abigaelbousquet/engn1650-bici-pcb/README.md

# engn1650-bici-pcb
Altium project for ENGN1650 Capstone Project: Bici Bike Indicator Helmet Attachment
