abigaelbousquet/engn1650-bici-pcb/bici-pcb-BOM-V5.xlsx

Name | Description | Designator | Quantity | Manufacturer | Manufacturer PN | Vendor | Vendor PN | Value | Package
GMC10X7R475K10NT | CAP0603 X7R 4.7UF 10% 10V | C1, C2, C401 | 3 | Cal-Chip Electronics, Inc. | GMC10X7R475K10NT | DigiKey | 4713-GMC10X7R475K10NTCT-ND | 4.7uF 10V | 0603
GRM188R61A106ME69D | CAP CER 10UF 10V X5R 0603 | C3, C4, C5 | 3 | Murata Electronics | GRM188R61A106ME69D | DigiKey | 490-10475-1-ND | 10 uF 10 V | 0603
KGM15AR70J104JT | CAP CER 0.1UF 6.3V X7R 0603 | C6, C101, C201, C202, C402, C403, C404, C405, C406 | 9 | KYOCERA AVX | KGM15AR70J104JT | DigiKey | 478-KGM15AR70J104JTCT-ND | 0.1uF 6.3V | 0603
GRM188R61E225KA12D | CAP CER 2.2UF 25V X5R 0603 | C102 | 1 | Murata Electronics | GRM188R61E225KA12D | DigiKey | 490-10731-1-ND | 2.2 uF 25 V | 0603
KGM15AV51H103ZT | CAP CER 10000PF 50V Y5V 0603 | C103 | 1 | KYOCERA AVX | KGM15AV51H103ZT | DigiKey | 478-KGM15AV51H103ZTCT-ND | 10 nF 50V | 0603
T1681UY--20C000212U1930 | LED AMBER CLEAR 4PLCC SMD | D1, D201, D202, D203, D204, D205, D206, D207, D208, D209, D210, D211, D212, D213, D214 | 15 | Harvatek Corporation | T1681UY--20C000212U1930 | DigiKey | 3147-T1681UY--20C000212U1930CT-ND |  | 4-PLCC
SDR08C04LP3-7B | DIODE SCHOTTK 4V 80MA X3DFN06032 | D301, D302 | 2 | Diodes Incorporated | SDR08C04LP3-7B | DigiKey | 31-SDR08C04LP3-7BCT-ND |  | 0201
AP3216ID | LED RED DIFFUSED CHIP SMD | D401 | 1 | Kingbright | AP3216ID | DigiKey | 754-AP3216IDCT-ND |  | 1206
USB4125-GF-A | CONN RCPT TYPE C 6P SMD RA | J1 | 1 | GCT | USB4125-GF-A | DigiKey | 2073-USB4125-GF-ACT-ND
0530480210 | CONN HEADER R/A 2POS 1.25MM | J2 | 1 | Molex | 0530480210 | DigiKey | WM1742-ND
3220-14-0100-00 | CONN HEADER VERT 14POS 1.27MM | J401 | 1 | CNC Tech | 3220-14-0100-00 | DigiKey | 1175-1630-ND
CIGW252010GL2R2MNE | FIXED IND 2.2UH 2.2A 93MOHM SMD | L1 | 1 | Samsung Electro-Mechanics | CIGW252010GL2R2MNE | DigiKey | 1276-6933-1-ND | 2.2uH | 1008
SP-1304 | SPEAKR 32OHM 200MW TOP PORT 88DB | LS1, LS2 | 2 | Soberton Inc. | SP-1304 | DigiKey | 433-1095-ND
RC0603FR-075K1L | RES 5.1K OHM 1% 1/10W 0603 | R1, R2 | 2 | YAGEO | RC0603FR-075K1L | DigiKey | 311-5.10KHRCT-ND | 5.1k | 0603
ERJ-3EKF4700V | RES SMD 470 OHM 1% 1/10W 0603 | R3, R401 | 2 | Panasonic Electronic Components | ERJ-3EKF4700V | Mouser | 667-ERJ-3EKF4700V | 470 | 0603
ERJ-3EKF2001V | RES SMD 2K OHM 1% 1/10W 0603 | R4 | 1 | Panasonic Electronic Components | ERJ-3EKF2001V | DigiKey | P2.00KHCT-ND | 2k | 0603
RT0603BRD0750KL | RES 50K OHM 0.1% 1/10W 0603 | R5, R6 | 2 | YAGEO | RT0603BRD0750KL | DigiKey | 13-RT0603BRD0750KLCT-ND | 50k | 0603
ERJ-3GEY0R00V | RES SMD 0 OHM JUMPER 1/10W 0603 | R10, R11 | 2 | Panasonic Electronic Components | ERJ-3GEY0R00V | DigiKey | P0.0GCT-ND | 0 | 0603
ERJ-3EKF1002V | RES SMD 10K OHM 1% 1/10W 0603 | R101, R102, R103, R104, R215, R216, R301, R303, R402, R404 | 10 | Panasonic Electronic Components | ERJ-3EKF1002V | Mouser | 667-ERJ-3EKF1002V | 10k | 0603
ERJ-3EKF1200V | RES SMD 120 OHM 1% 1/10W 0603 | R201, R202, R203, R204, R205, R206, R207, R208, R209, R210, R211, R212, R213, R214 | 14 | Panasonic Electronic Components | ERJ-3EKF1200V | DigiKey | P120HCT-ND | 120 | 0603
ERJ-P06J110V | RES SMD 11 OHM 5% 1/2W 0805 | R302, R304 | 2 | YAGEO | ERJ-P06J110V | DigiKey | P11ADCT-ND | 11 | 0805
SLW-864574-5A-RA-N-D | 8.6 X 4.5 X 6.2 MM, 5 MM RAISED | SW1 | 1 | Same Sky (Formerly CUI Devices) | SLW-864574-5A-RA-N-D | DigiKey | 2223-SLW-864574-5A-RA-N-D-ND
MCP73831T-2ATI/OT | IC BATT CNTL LI-ION 1CEL SOT23-5 | U1 | 1 | Microchip Technology | MCP73831T-2ATI/OT | DigiKey | MCP73831T-2ATI/OTCT-ND |  | SOT-23-5
RT6150B-33GQW | IC REG BCK BST 3.3V 800MA 10WDFN | U2 | 1 | Richtek USA Inc. | RT6150B-33GQW | DigiKey | RT6150B-33GQWCT-ND |  | 10-WDFN
ICM-42670-P | IMU ACCEL/GYRO/TEMP I2C/SPI | U101 | 1 | TDK InvenSense | ICM-42670-P | Mouser | 410-ICM-42670-P |  | LGA-14
MC74HC244ADTR2G | IC BUFFER NON-INVERT 6V 20-TSSOP | U201, U202 | 2 | onsemi | MC74HC244ADTR2G | DigiKey | MC74HC244ADTR2GOSCT-ND |  | 20-TSSOP
DMG1012UW-7 | MOSFET N-CH 20V 1A SOT323 | U301, U302 | 2 | Diodes Incorporated | DMG1012UW-7 | DigiKey | DMG1012UW-7DICT-ND |  | SOT-323
STM32L412C8T6 | IC MCU 32BIT 64KB FLASH 48LQFP | U401 | 1 | STMicroelectronics | STM32L412C8T6 | DigiKey | 497-STM32L412C8T6-ND |  | 48-LQFP
