abigaelbousquet/engn1650-bici-pcb/bici-pcb-V4.pdf

USB-C | Li Ion Battery

## Power Charger

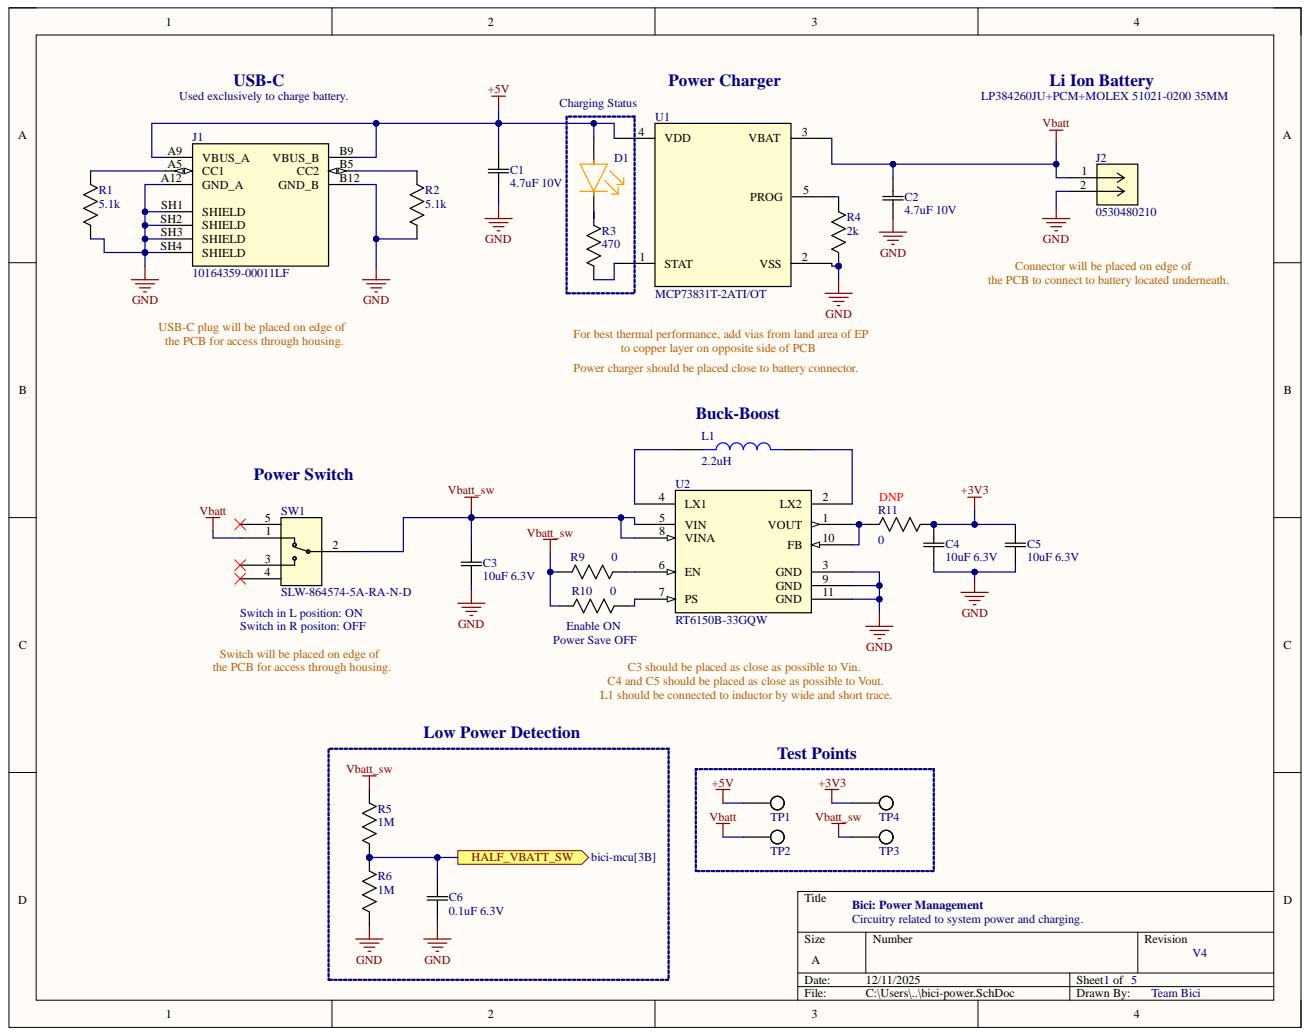
[picture p13: page 1]

Charging Status Used exclusively to charge battery.

Connector will be placed on edge of
the PCB to connect to battery located underneath.

USB-C plug will be placed on edge of
the PCB for access through housing.

For best thermal performance, add vias from land area of EP

to copper layer on opposite side of PCB

Power charger should be placed close to battery connector.

Switch in L position: ON
Switch in R positon: OFF

Switch will be placed on edge of

C3 should be placed as close as possible to Vin.
C4 and C5 should be placed as close as possible to Vout.
L1 should be connected to inductor by wide and short trace.

Bici: Power Management
Circuitry related to system power and charging.

## Test Points

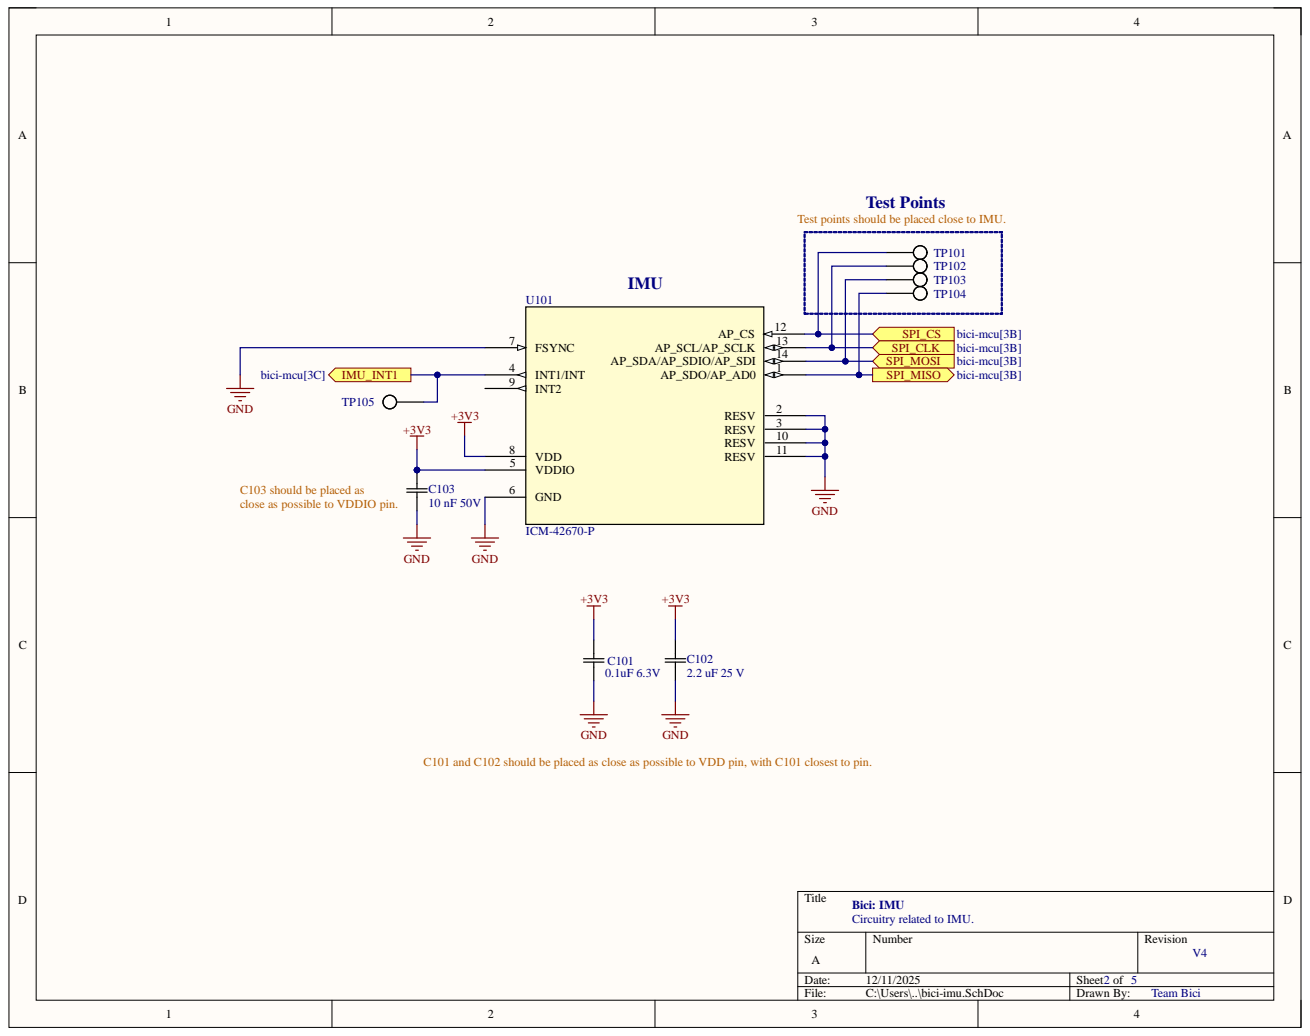
[picture p14: page 2]

Test points should be placed close to IMU.

C103 should be placed as
close as possible to VDDIO pin.

C101 and C102 should be placed as close as possible to VDD pin, with C101 closest to pin.

Bici: IMU
Circuitry related to IMU.

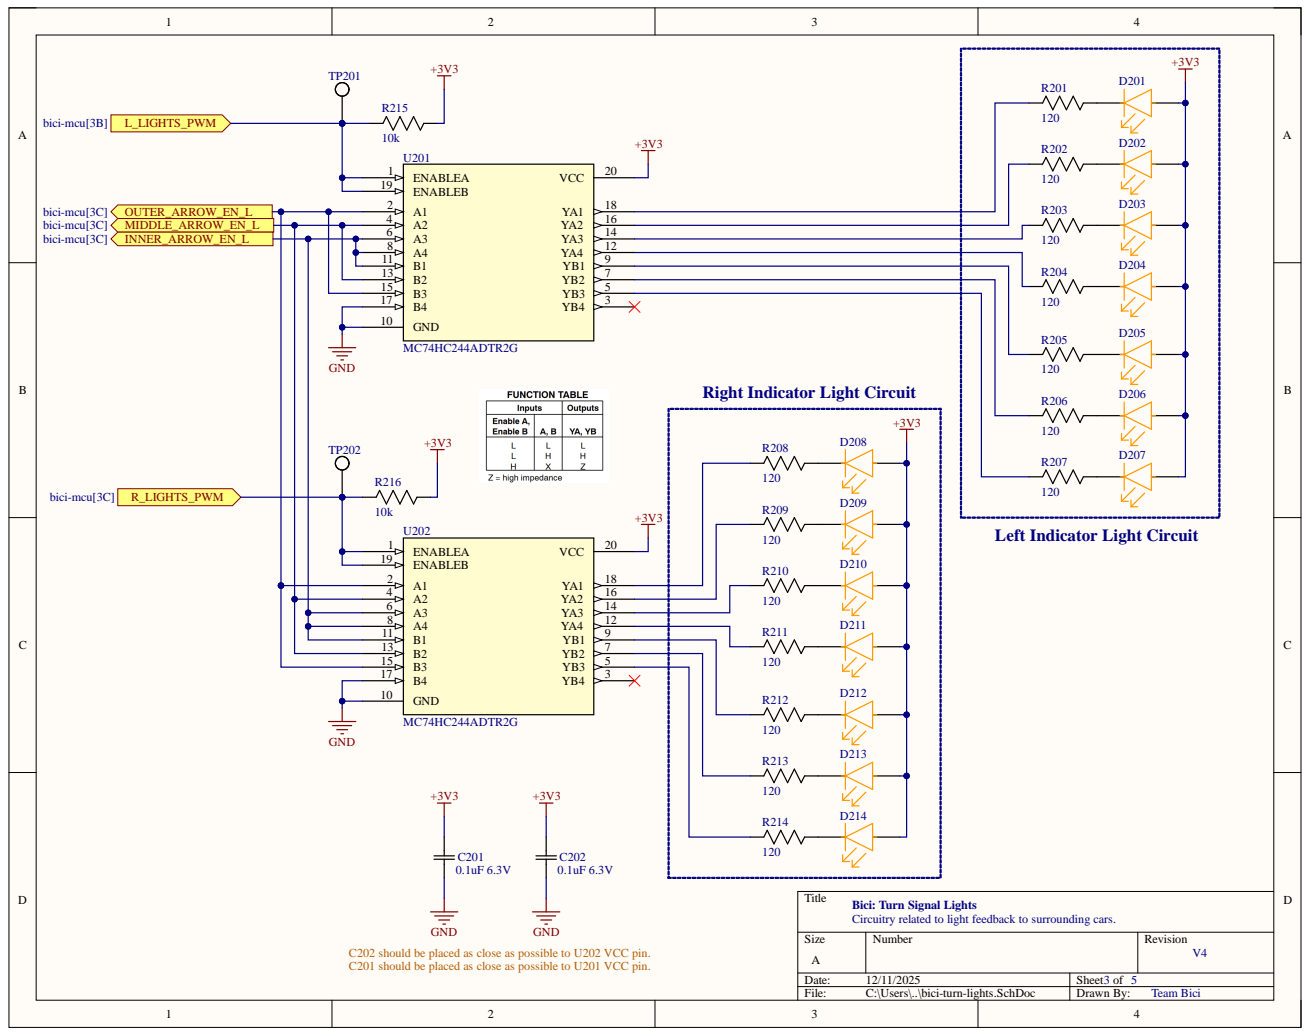
[picture p15: page 3]

Right Indicator Light Circuit

Left Indicator Light Circuit

Bici: Turn Signal Lights
Circuitry related to light feedback to surrounding cars.

C202 should be placed as close as possible to U202 VCC pin.
C201 should be placed as close as possible to U201 VCC pin.

## Left Indicator Audio Feedback Circuit

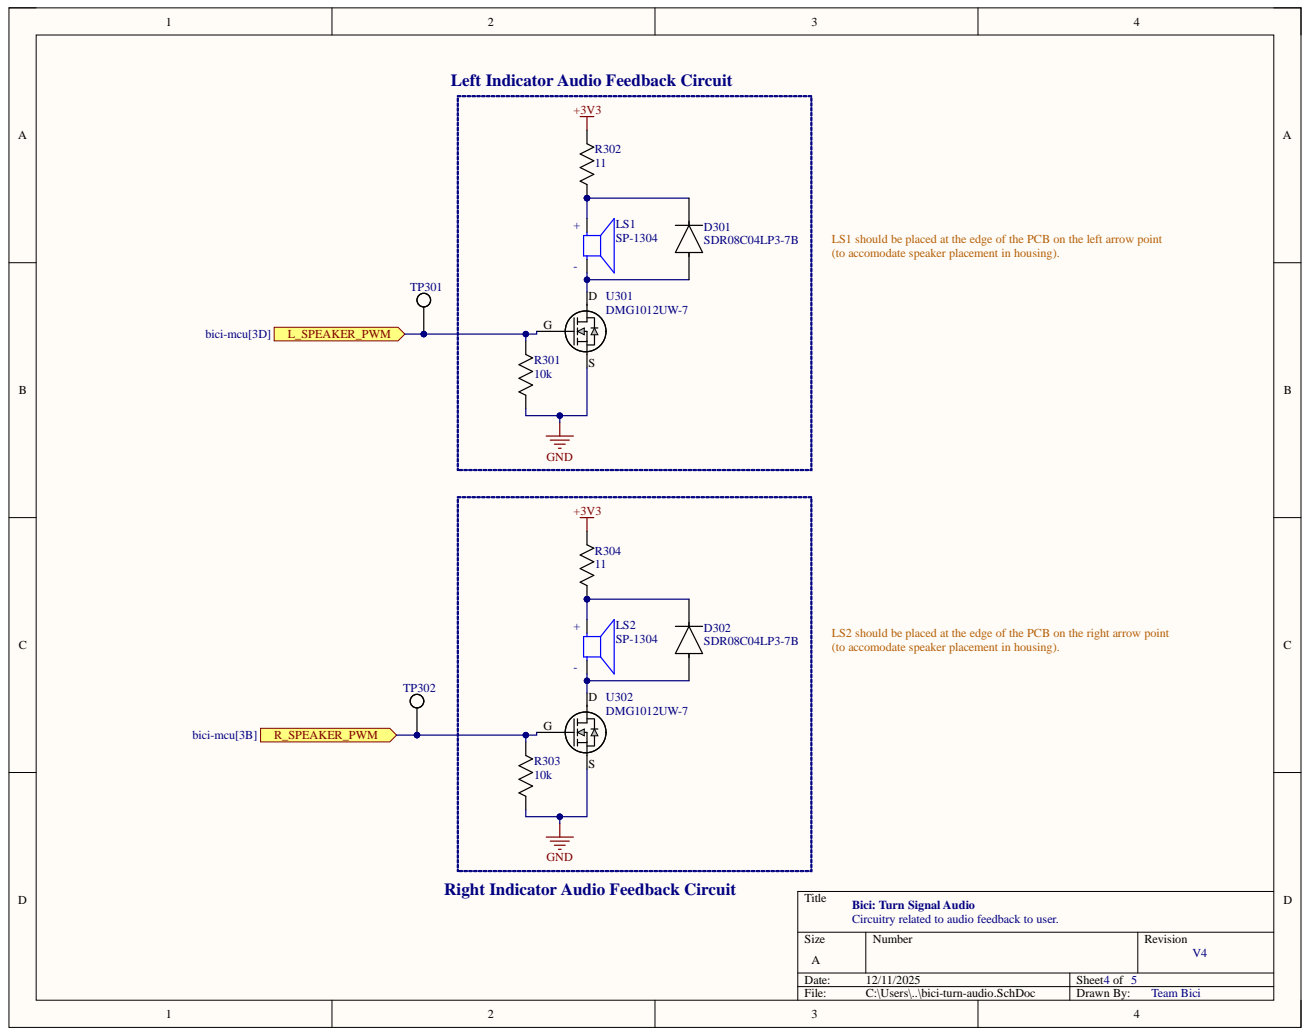
[picture p16: page 4]

LS1 should be placed at the edge of the PCB on the left arrow point
(to accomodate speaker placement in housing).

LS2 should be placed at the edge of the PCB on the right arrow point

Right Indicator Audio Feedback Circuit

Bici: Turn Signal Audio
Circuitry related to audio feedback to user.

STM Power | STM I/O

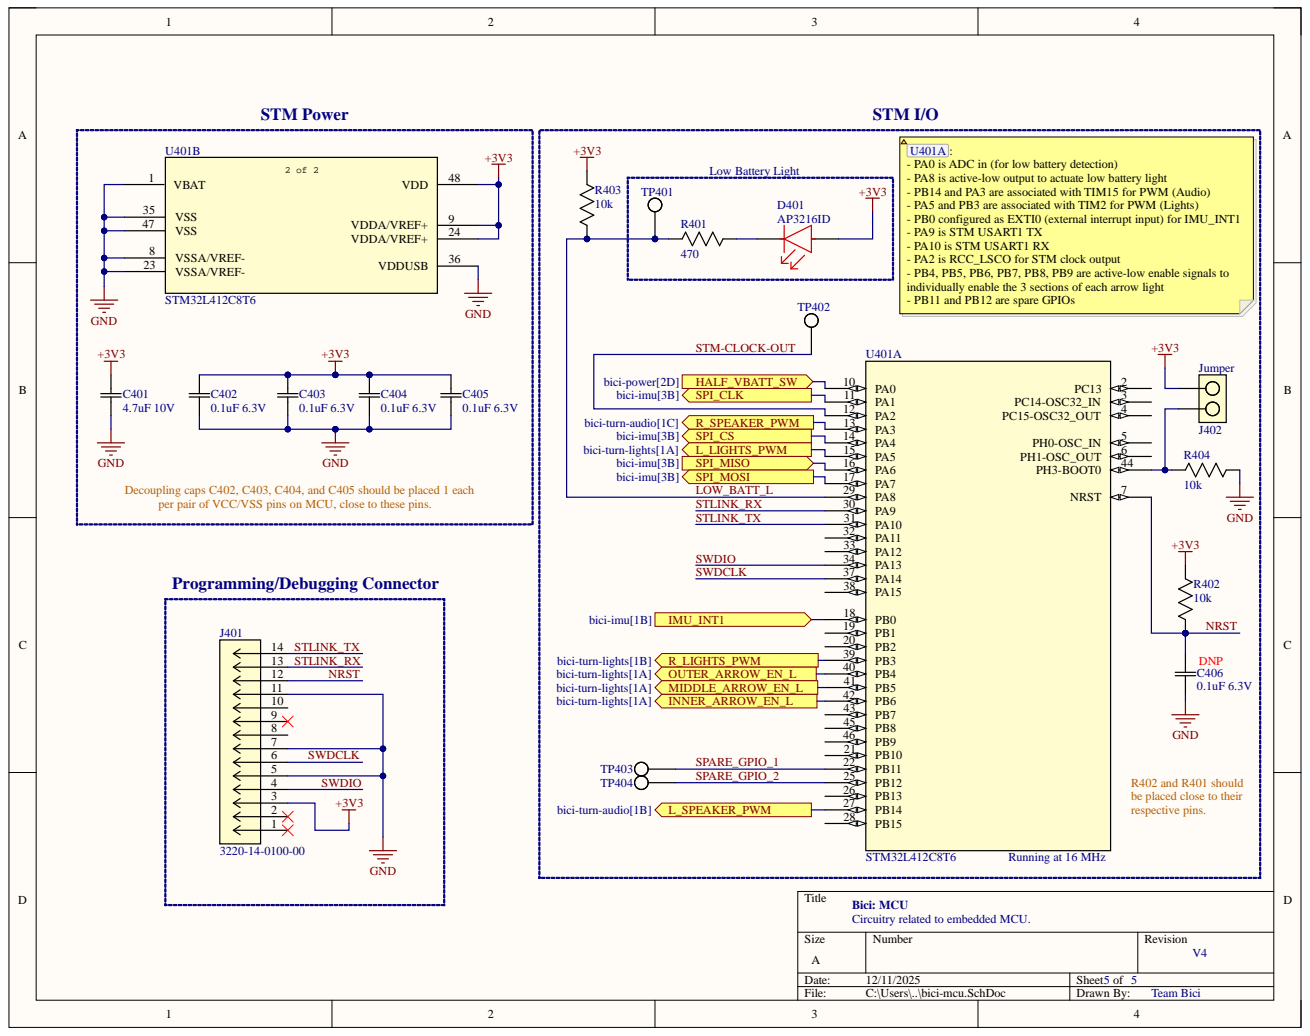
[picture p17: page 5]
