abigaelbousquet/engn1650-bici-pcb/bici-pcb-V2.pdf

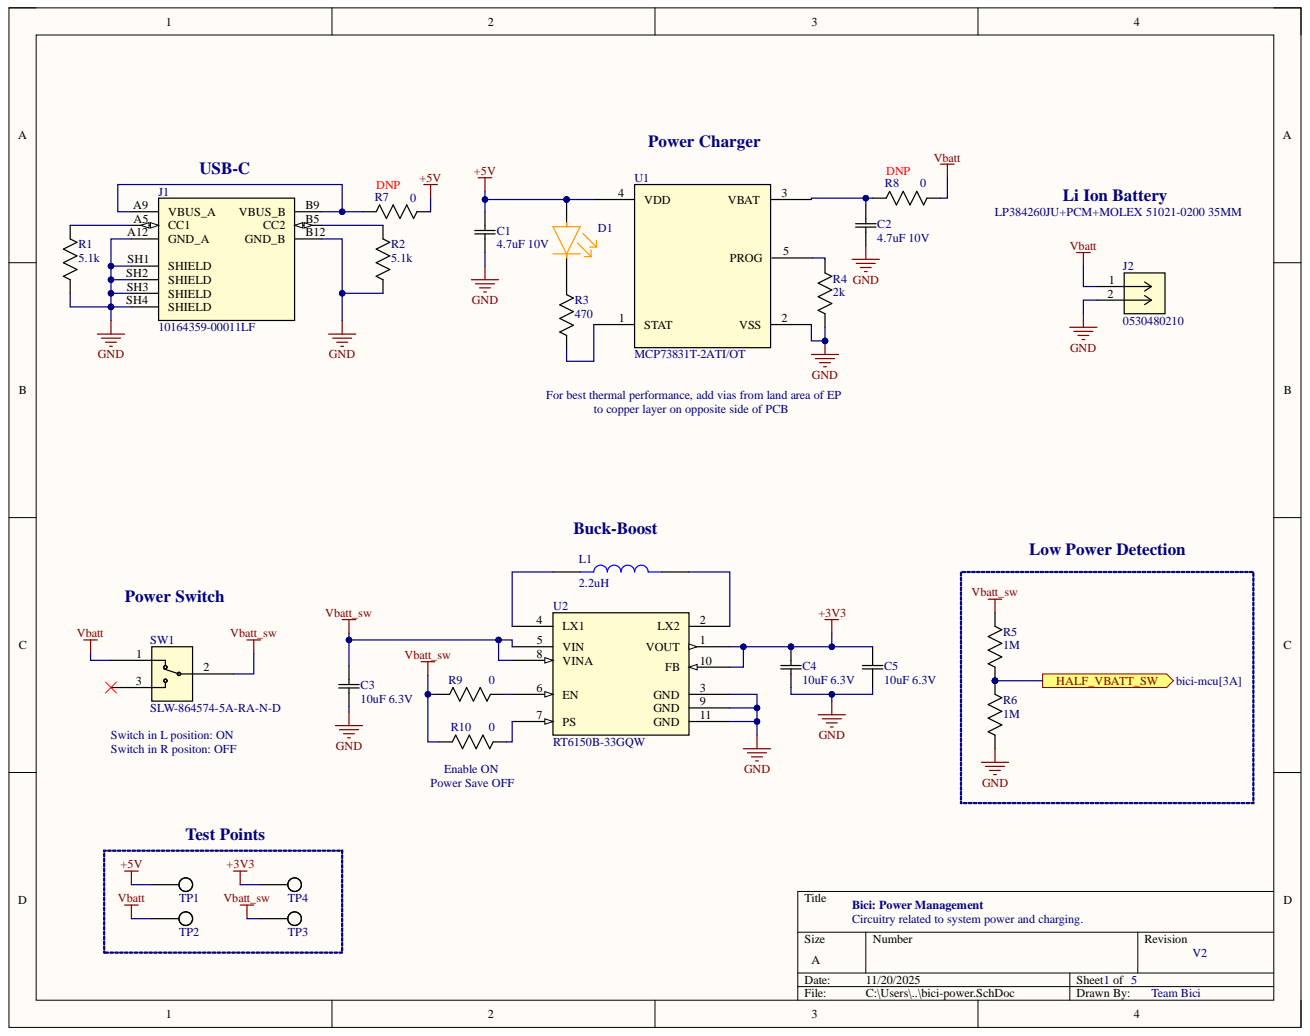
[picture p23: page 1]

For best thermal performance, add vias from land area of EP

to copper layer on opposite side of PCB

Switch in L position: ON
Switch in R positon: OFF

Bici: Power Management
Circuitry related to system power and charging.

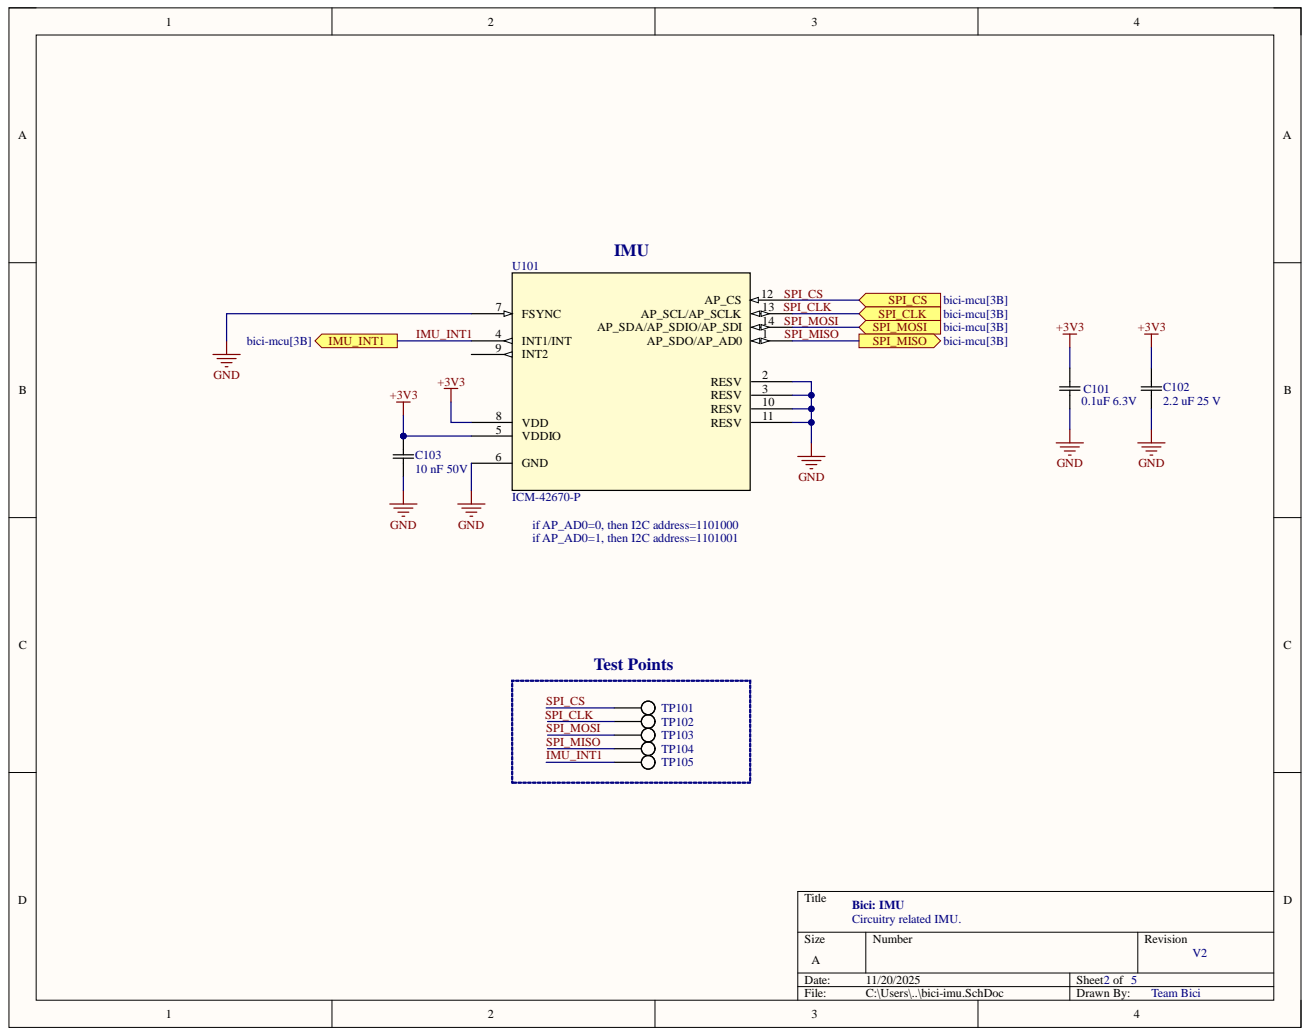
[picture p24: page 2]

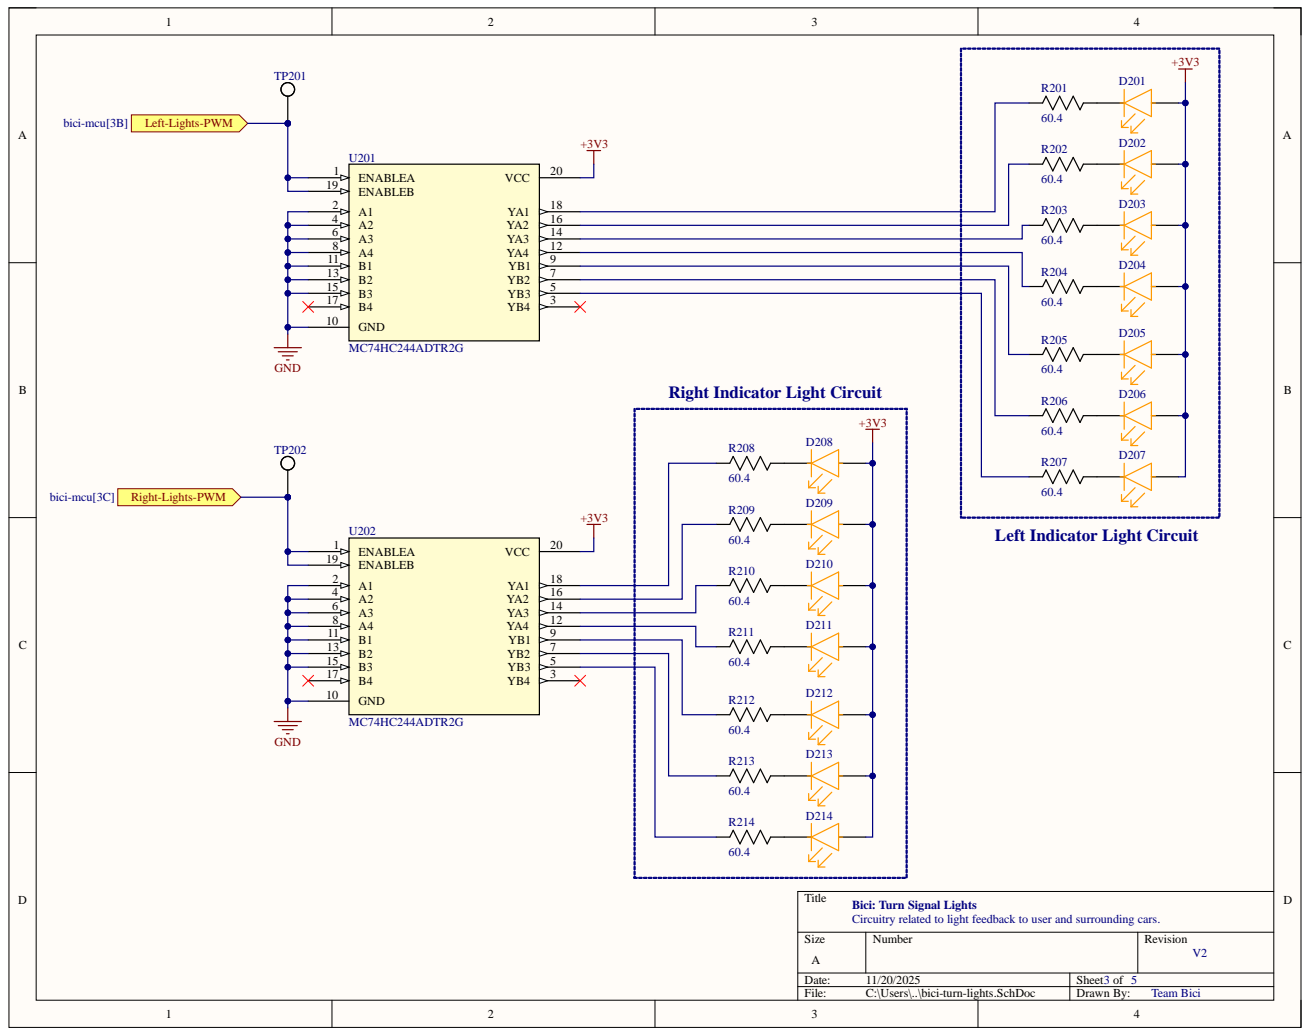
[picture p25: page 3]

Right Indicator Light Circuit

Left Indicator Light Circuit

Bici: Turn Signal Lights
Circuitry related to light feedback to user and surrounding cars.

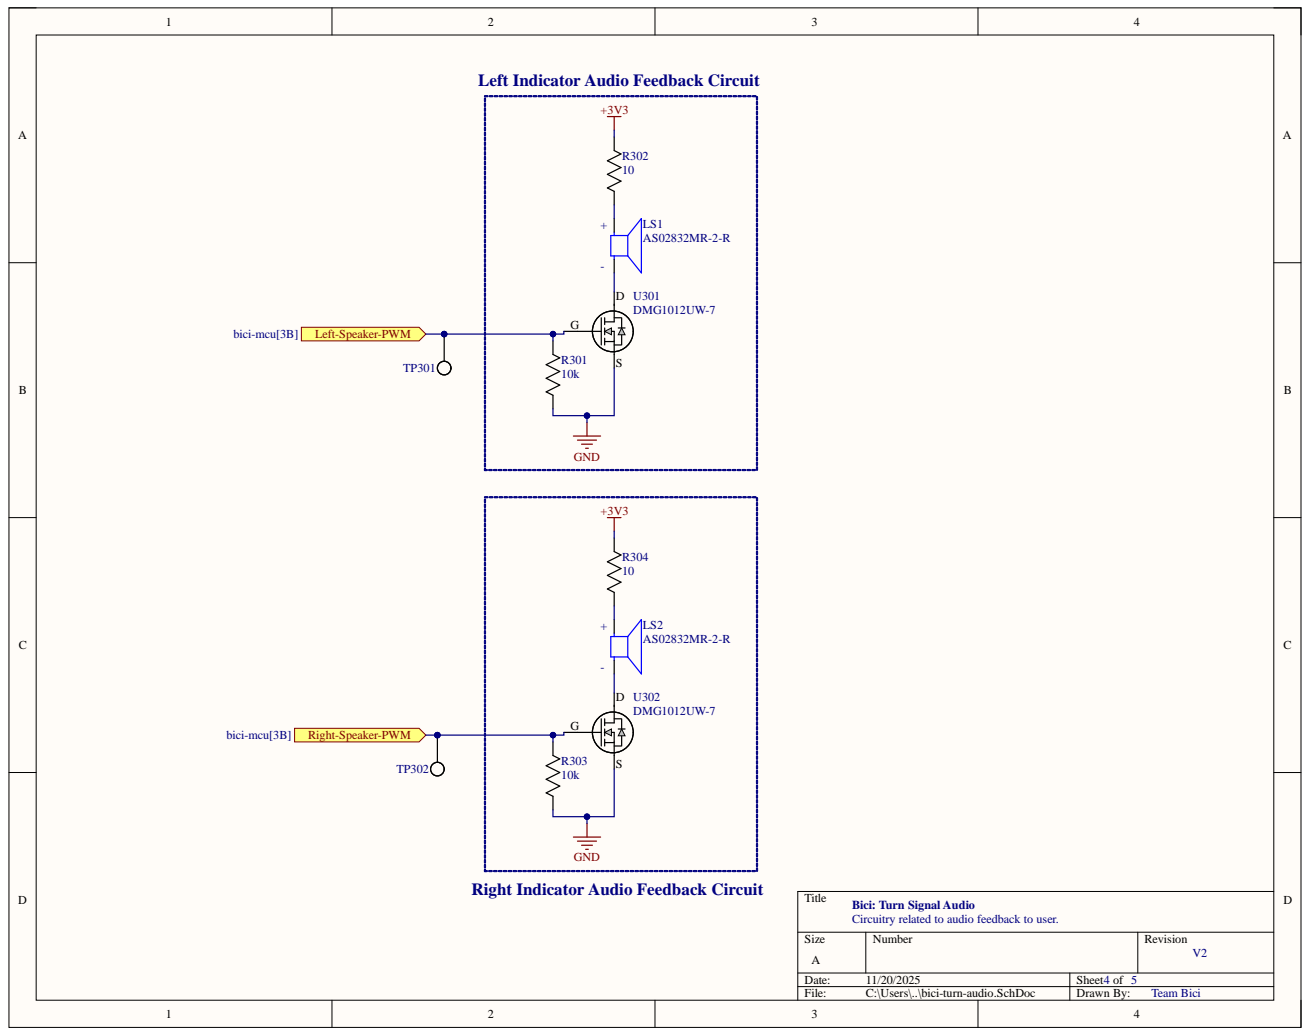
[picture p26: page 4]

Left Indicator Audio Feedback Circuit

Right Indicator Audio Feedback Circuit

Bici: Turn Signal Audio
Circuitry related to audio feedback to user.

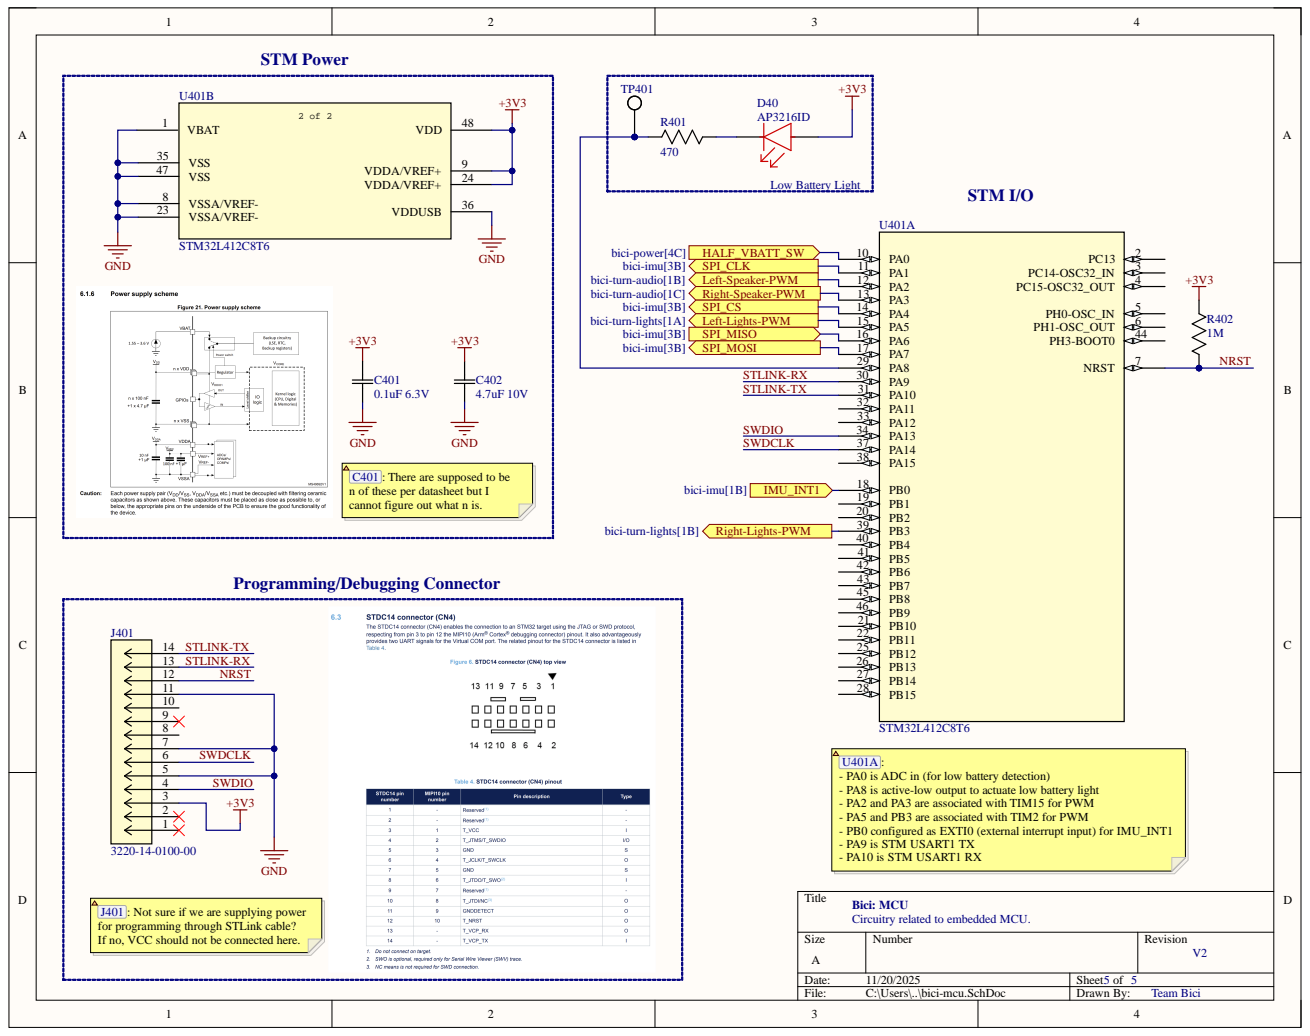
[picture p27: page 5]
