abigaelbousquet/engn1650-bici-pcb/(list of files, drawings)

Other design files:
bici-pcb/bici-imu.SchDoc
bici-pcb/bici-mcu.SchDoc
bici-pcb/bici-pcb.PcbDoc
bici-pcb/bici-pcb.PrjPcb
bici-pcb/bici-power.SchDoc
bici-pcb/bici-turn-audio.SchDoc
bici-pcb/bici-turn-lights.SchDoc
