abigaelbousquet/engn1650-bici-pcb/(commit log)

2025-11-11 created schematics and added sheet metadata
    [bici-mcu-imu.SchDoc, bici-pcb.PrjPcb, bici-power.SchDoc, bici-user-feedback.SchDoc]
2025-11-11 started wiring up USB C plug in power sch
    [bici-power.SchDoc]
2025-11-11 finished draft A1 of power schematic
    [bici-pcb.PrjPcb, bici-power.SchDoc]
2025-11-11 added light circuits
    [bici-turn-lights.SchDoc, bici-user-feedback.SchDoc]
2025-11-11 added new, 4th schematic for audio feedback
    [bici-mcu-imu.SchDoc, bici-pcb.PrjPcb, bici-power.SchDoc, bici-turn-audio.SchDoc]
2025-11-12 renumbered Us in lights, added circuitry in audio sch
    [bici-turn-audio.SchDoc, bici-turn-lights.SchDoc]
2025-11-12 added boxes for readability
    [bici-turn-audio.SchDoc]
2025-11-12 separated out imu and mcu schematics, copied over maddie's IMU schematic
    [bici-imu.SchDoc, bici-mcu-imu.SchDoc, bici-mcu.SchDoc, bici-pcb.PrjPcb, bici-power.SchDoc, bici-turn-audio.SchDoc, bici-turn-lights.SchDoc]
2025-11-12 mcu schematic added and connected to everything
    [bici-imu.SchDoc, bici-mcu.SchDoc, bici-power.SchDoc, bici-turn-audio.SchDoc, bici-turn-lights.SchDoc]
2025-11-12 exported pdf of schematics for presentation
    [bici-imu.SchDoc, bici-pcb.PrjPcb]
2025-11-13 a wire was missing
    [bici-turn-lights.SchDoc]
2025-11-16 edits to mcu sch following initial schematic review
    [bici-mcu.SchDoc]
2025-11-16 raised resistance on low power volt div to 1Mohm, hooked up IMU_INT1 to MCU
    [bici-imu.SchDoc, bici-mcu.SchDoc, bici-power.SchDoc]
2025-11-16 flipped CS pin on IMU to other side of schematic to appease harvey
    [bici-imu.SchDoc, bici-pcb.PrjPcb]
2025-11-16 changed all revisions to V2
    [bici-imu.SchDoc, bici-mcu.SchDoc, bici-power.SchDoc, bici-turn-audio.SchDoc, bici-turn-lights.SchDoc]
2025-11-16 added note about I2C addr, changed 0.1uF cap to 10V from 100V
    [bici-imu.SchDoc]
2025-11-16 added 0 ohm jumpers before all pwr voltage nets
    [bici-power.SchDoc]
2025-11-16 renamed all +3.3V pwr ports to be +3V3
    [bici-imu.SchDoc, bici-mcu.SchDoc, bici-power.SchDoc, bici-turn-audio.SchDoc, bici-turn-lights.SchDoc]
2025-11-17 swapped J401 for a 50 mil pitch header following Ted's general notes on slack
    [bici-mcu.SchDoc]
2025-11-17 added a bunch of test points
    [bici-imu.SchDoc, bici-mcu.SchDoc, bici-power.SchDoc, bici-turn-audio.SchDoc, bici-turn-lights.SchDoc]
2025-11-17 added note for low battery light
    [bici-mcu.SchDoc]
2025-11-18 fixed and exported BOM (one cap had misspell)
    [bici-imu.SchDoc, bici-pcb-BOM-V2.xlsx]
2025-11-19 switched switch
    [bici-power.SchDoc]
2025-11-19 changed battery to new flatter one
    [bici-power.SchDoc]
2025-11-19 added notes on switch
    [bici-power.SchDoc]
2025-11-19 swapped to new buck boost
    [bici-power.SchDoc]
2025-11-20 made pwr jumpers DNP labeled in sheet (left as Standard incl part for BOM though)
    [bici-power.SchDoc]
2025-11-20 swapped USBC 5.1k resistors for an in stock one
    [bici-power.SchDoc]
2025-11-20 debug connector replaced and wired up
    [bici-mcu.SchDoc, bici-power.SchDoc]
2025-11-21 swapped 0.1uF caps that were 0201 to 0603 ones
    [bici-imu.SchDoc, bici-mcu.SchDoc]
2025-11-21 exported V2
    [bici-imu.SchDoc, bici-mcu.SchDoc, bici-pcb-BOM-V2.xlsx, bici-pcb.PrjPcb, bici-power.SchDoc, bici-turn-audio.SchDoc, bici-turn-lights.SchDoc]
2025-12-02 renamed everything to V3
    [bici-imu.SchDoc, bici-mcu.SchDoc, bici-power.SchDoc, bici-turn-audio.SchDoc, bici-turn-lights.SchDoc]
2025-12-02 updated speaker circuits with new smaller speaker
    [bici-turn-audio.SchDoc]
2025-12-02 added pull ups so all lights are off on startup
    [bici-mcu.SchDoc, bici-turn-lights.SchDoc]
2025-12-02 added the other 3 decoupling caps for STM
    [bici-mcu.SchDoc]
2025-12-02 added pull down and jumper for BOOT0
    [bici-mcu.SchDoc]
2025-12-02 minor cleanup
    [bici-mcu.SchDoc]
2025-12-02 swapped to cheaper 10uF cap maddie sent (GRM188R60J106ME47D) for buck boost
    [bici-power.SchDoc]
2025-12-02 got rid of irrelevant annotation for I2C
    [bici-imu.SchDoc]
2025-12-02 exported new pdf and bom
    [bici-pcb.xlsx]
2025-12-04 edits following general comments from Ted on V2
    [bici-imu.SchDoc, bici-mcu.SchDoc, bici-pcb.PrjPcb, bici-power.SchDoc]
2025-12-04 minor cleanup, moved text to be centered
    [bici-mcu.SchDoc]
2025-12-04 updated speakers to reflect silkscreen changes in footprint
    [bici-turn-audio.SchDoc]
2025-12-05 organization edits
    [bici-mcu.SchDoc, bici-power.SchDoc]
2025-12-08 updated switch schematic to have mounting holes
    [bici-pcb.PrjPcb, bici-power.SchDoc]
2025-12-08 fixed pinout on 14 pin header footprint & updated in sch
    [bici-mcu.SchDoc]
2025-12-08 indicator lights broken in 3 sections, each enabled by a GPIO
    [bici-mcu.SchDoc, bici-power.SchDoc, bici-turn-lights.SchDoc]
2025-12-08 added TPs for 2 spare GPIOs, standardized net names
    [bici-mcu.SchDoc]
2025-12-08 generated netlist, no errors
    [bici-mcu.SchDoc, bici-pcb.PrjPcb, bici-power.SchDoc, bici-turn-audio.SchDoc]
2025-12-08 updated all components from libraries & created pcb file
    [bici-pcb.PcbDoc, bici-pcb.PrjPcb, bici-power.SchDoc]
2025-12-08 pulled all components into pcb
    [bici-imu.SchDoc, bici-mcu.SchDoc, bici-pcb.PcbDoc, bici-pcb.PrjPcb, bici-turn-audio.SchDoc, bici-turn-lights.SchDoc]
2025-12-08 swapped resistors in light circuits to 120 ohms for worst case
    [bici-pcb.PcbDoc, bici-turn-lights.SchDoc]
2025-12-08 shifted everything for better readability
    [bici-turn-lights.SchDoc]
2025-12-08 added layout notes to power sheet
    [bici-pcb.xlsx, bici-power.SchDoc]
2025-12-08 added layout notes for all major components / ICs / connectors
    [bici-imu.SchDoc, bici-mcu.SchDoc, bici-power.SchDoc, bici-turn-audio.SchDoc, bici-turn-lights.SchDoc]
2025-12-08 checking / updating sheet metadata
    [bici-imu.SchDoc, bici-power.SchDoc, bici-turn-lights.SchDoc]
2025-12-08 exported bom and pdf of schematics
    [bici-pcb.xlsx]
2025-12-08 renamed low power diode R401, board shape to maddie's cad, started layout of key parts
    [bici-mcu.SchDoc, bici-pcb.PcbDoc]
2025-12-08 flip flopped switch and USB C in layout
    [bici-pcb.PcbDoc]
2025-12-08 updated note about operating frequency of mcu
    [bici-mcu.SchDoc]
2025-12-08 exported V3 BOM and schematic PDF
    [bici-pcb-BOM-V3.xlsx]
2025-12-09 updated 0.1uF caps and sch symbol for jumper in mcu sheet
    [bici-imu.SchDoc, bici-mcu.SchDoc, bici-pcb.PcbDoc, bici-pcb.PrjPcb, bici-power.SchDoc, bici-turn-audio.SchDoc, bici-turn-lights.SchDoc]
2025-12-09 exported updated V3 schematic PDF and BOM
    [bici-pcb-BOM-V3.xlsx, bici-pcb.xlsx]
2025-12-11 sch changes from feedback after final presentation
    [bici-mcu.SchDoc, bici-power.SchDoc, bici-turn-audio.SchDoc, bici-turn-lights.SchDoc]
2025-12-11 V4 export of schematic and BOM
    [bici-imu.SchDoc, bici-mcu.SchDoc, bici-pcb-BOM-V4.xlsx, bici-pcb.PcbDoc, bici-power.SchDoc, bici-turn-audio.SchDoc, bici-turn-lights.SchDoc]
2026-02-12 a few changes after s26 kickoff meeting
    [bici-mcu.SchDoc, bici-power.SchDoc, bici-turn-audio.SchDoc]
2026-02-17 V5 changes associated with changes after kickoff meeting
    [bici-imu.SchDoc, bici-mcu.SchDoc, bici-power.SchDoc, bici-turn-audio.SchDoc, bici-turn-lights.SchDoc]
2026-02-17 exported BOM with changes
    [bici-pcb.xlsx]
2026-02-17 updated USB C to in-stock one
    [bici-power.SchDoc]
2026-02-18 updated all parts from library with recent changes
    [bici-imu.SchDoc, bici-mcu.SchDoc, bici-pcb.PrjPcb, bici-power.SchDoc, bici-turn-audio.SchDoc, bici-turn-lights.SchDoc]
2026-02-18 nvm this actually updated all the params for all components (following vendor updates for some)
    [bici-imu.SchDoc, bici-mcu.SchDoc, bici-pcb.PrjPcb, bici-pcb.xlsx, bici-power.SchDoc, bici-turn-audio.SchDoc, bici-turn-lights.SchDoc]
2026-02-18 added spare 0603 footprints
    [bici-imu.SchDoc]
2026-02-18 VDDUSB tied to VDD per Ken's instruction
    [bici-mcu.SchDoc]
2026-02-22 updated everything from library
    [bici-turn-audio.SchDoc]
2026-02-22 clean save after update from library
    [bici-imu.SchDoc, bici-mcu.SchDoc, bici-power.SchDoc, bici-turn-audio.SchDoc, bici-turn-lights.SchDoc]
2026-02-22 updated stackup to match standard 4 layer board with 1oz copper
    [bici-pcb.PcbDoc]
2026-02-22 clean save, named plane layers better
    [bici-pcb.PcbDoc]
2026-02-22 created board shape, centered origin, and created board outline
    [bici-pcb.PcbDoc]
2026-02-22 fresh update from libraries because didn't import to pcb right
    [bici-imu.SchDoc, bici-mcu.SchDoc, bici-pcb.PcbDoc, bici-power.SchDoc, bici-turn-audio.SchDoc, bici-turn-lights.SchDoc]
2026-02-22 imported everything to PCB
    [bici-imu.SchDoc, bici-mcu.SchDoc, bici-pcb.PcbDoc, bici-pcb.PrjPcb, bici-power.SchDoc, bici-turn-audio.SchDoc, bici-turn-lights.SchDoc]
2026-02-22 moved and locked components whose location matter
    [bici-pcb.PcbDoc]
2026-02-22 fresh save before we start routing
    [bici-pcb.PcbDoc]
2026-02-23 rotated board 180 degrees for clearer view & correct IMU orientation
    [bici-pcb.PcbDoc]
2026-02-23 redid placement of fixed components, got rid of Mech13 on a few parts
    [bici-imu.SchDoc, bici-mcu.SchDoc, bici-pcb.PcbDoc, bici-pcb.PrjPcb, bici-power.SchDoc, bici-turn-lights.SchDoc]
2026-02-23 a lot of layout. no routing yet
    [bici-pcb.PcbDoc, bici-power.SchDoc]
2026-02-23 switched spare GPIO for cleaner routing
    [bici-mcu.SchDoc]
2026-02-23 more layout
    [bici-pcb.PcbDoc, bici-turn-audio.SchDoc]
2026-02-23 end of night save, mid layout
    [bici-pcb.PcbDoc]
2026-02-23 intermediate layout save
    [bici-pcb.PcbDoc]
2026-02-23 some design rule changes (see slack message for details)
    [bici-pcb.PcbDoc]
2026-02-23 layout done, starting routing
    [bici-pcb.PcbDoc]
2026-02-24 intermediate save (mid routing)
    [bici-pcb.PcbDoc, bici-turn-lights.SchDoc]
2026-02-24 everything routed!
    [bici-pcb.PcbDoc]
2026-02-24 done routing, started design rule checks
    [bici-pcb.PcbDoc]
2026-02-24 done for the night
    [bici-pcb.PcbDoc]
2026-02-24 working on fixing design rule violations
    [bici-pcb.PcbDoc]
2026-02-24 updated footprints for USBC, buck boost, + LED driver ICs to reduce DRC violations
    [bici-pcb.PcbDoc, bici-power.SchDoc, bici-turn-lights.SchDoc]
2026-02-24 updated footprints for IMU and teeny diodes in speaker circuits, passing most DRC now
    [bici-imu.SchDoc, bici-pcb.PcbDoc, bici-turn-audio.SchDoc]
2026-02-24 got rid of some temporary net labels from layout
    [bici-turn-lights.SchDoc]
2026-02-24 fresh save and export of PDF and BOM
    [bici-imu.SchDoc, bici-pcb.PrjPcb, bici-pcb.xlsx, bici-power.SchDoc, bici-turn-audio.SchDoc, bici-turn-lights.SchDoc]
2026-02-24 saved V5 pdfs and bom
    [bici-pcb-BOM-V5.xlsx]
2026-02-24 moved a few things on call with maddie, also exported step
    [bici-pcb.PcbDoc, bici-pcb.step]
2026-02-24 exported another version of step file
    [bici-pcb-notcombined.step]
2026-02-25 feedback following design review with Ted & Ken
    [bici-pcb.PcbDoc, bici-pcb.step]
2026-02-25 export of gerbers, pdf, and ncdrill for Ken
    [bici-pcb-notcombined.step, bici-pcb.PrjPcb, bici-pcb.step, bici-pcb.xlsx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]
2026-02-26 changed inner layers to signal w/ polygon fills to invert on gerbers, also updated silkscreen label
    [bici-pcb.PcbDoc]
2026-02-26 exported fab files
    [bici-pcb.PrjPcb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]
2026-02-26 moved silkscreen that was on top of via
    [bici-pcb.PcbDoc]
2026-02-26 re exported gerbers and NCDrill for fab
    [bici-pcb.PrjPcb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]
